Obeisance/Arduino-ECG-Monitor/IMG_20200314_070831966.jpg

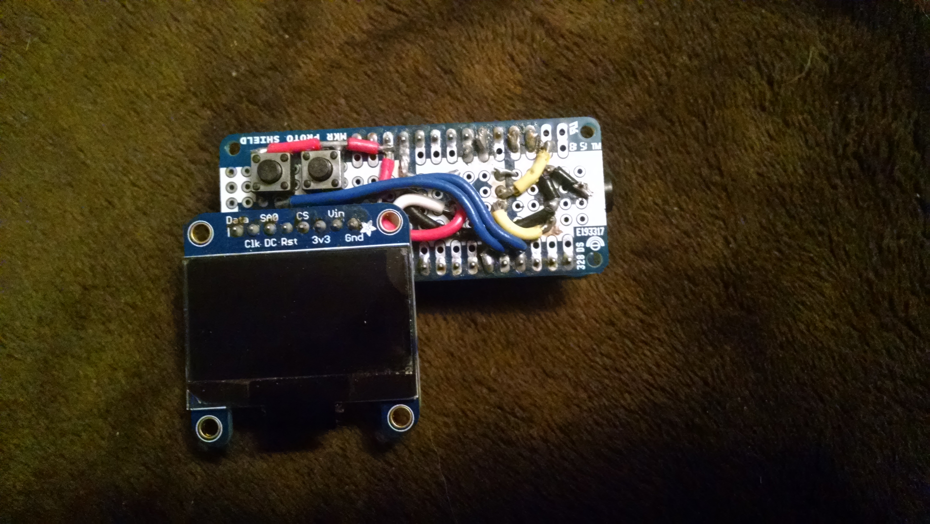
IMG_20200314_070831966.jpg
