Obeisance/Arduino-ECG-Monitor/IMG_20200314_070901912.jpg

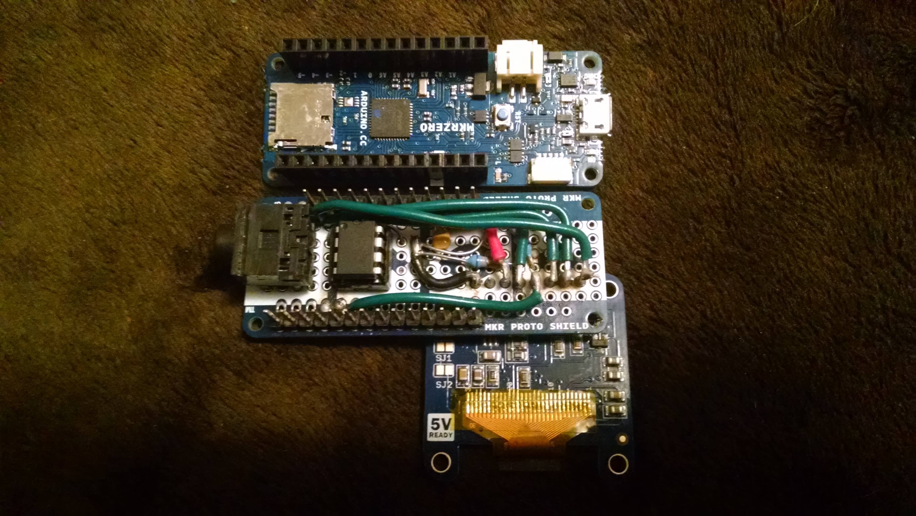
IMG_20200314_070901912.jpg
