Obeisance/Arduino-ECG-Monitor/2022-02-28 ECG normal.png

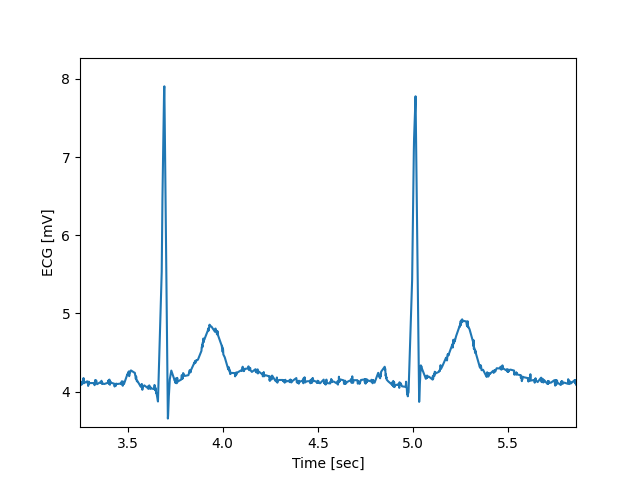
2022-02-28 ECG normal.png
