Obeisance/Arduino-ECG-Monitor/2022-02-28 ECG with pulse change.png

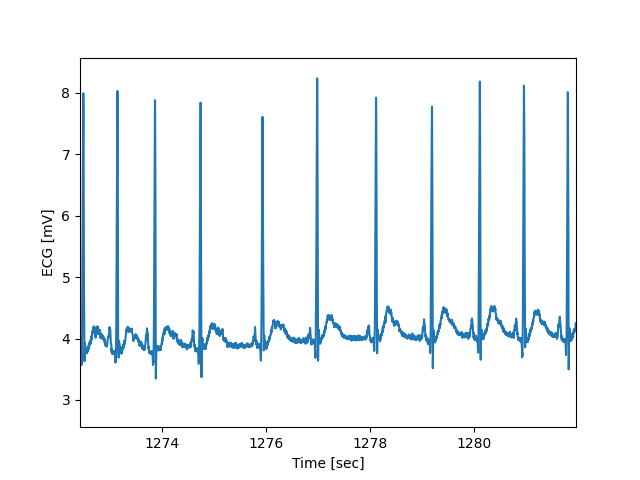
2022-02-28 ECG with pulse change.png
