Obeisance/Arduino-ECG-Monitor/2022-02-28 ECG with PVC during run.png

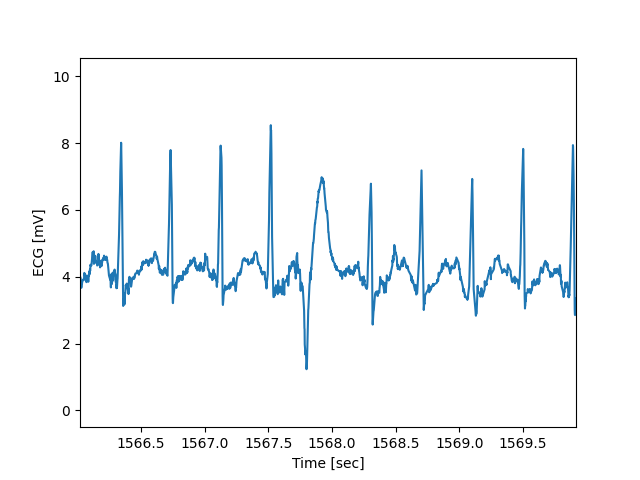
2022-02-28 ECG with PVC during run.png
