Obeisance/Arduino-ECG-Monitor/2022-02-28 pulse incl run.png

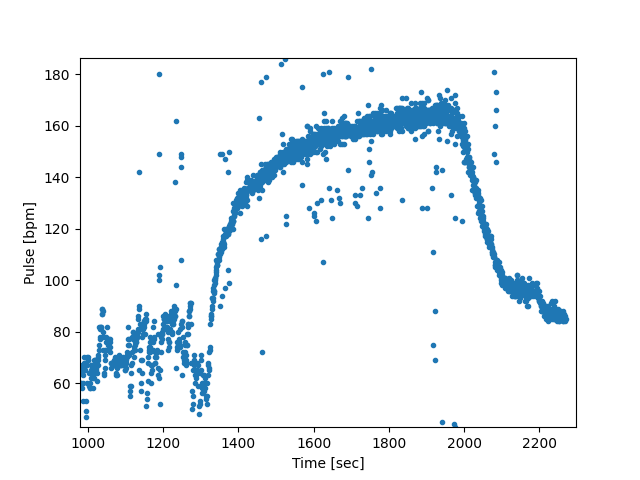
2022-02-28 pulse incl run.png
