Obeisance/Arduino-ECG-Monitor/2020-03-14 ECG part list.xlsx

Component | Part number | Cost (USD) | quantity | link
Arduino MKR zero (I did not include the micro USB cable needed to charge this) | 782-ABX00012 | 24.09 | 1 | https://www.mouser.com/ProductDetail/Arduino/ABX00012
Arduino MKR proto-shield | 782-TSX00001 | 7.99 | 1 | https://www.mouser.com/ProductDetail/?qs=5aG0NVq1C4w1oyNWErt3iA%3D%3D
AD627 Instrumentation amplifier | 584-AD627BNZ | 11.21 | 1 | https://www.mouser.com/ProductDetail/Analog-Devices/AD627BNZ?qs=sGAEpiMZZMsE1dKaA2ImUCv9orK1DwfJVGszVMhWZpw%3D
619 ohm gain resistor | 279-YR1B619RCC | 0.47 | 1 | https://www.mouser.com/ProductDetail/TE-Connectivity-Neohm/YR1B619RCC
8 pin chip socket | 485-2202 | 0.75 | 1 | https://www.mouser.com/ProductDetail/Adafruit/2202
5 pin, 3.5mm audio jack | 1699 | 0.95 | 1 | https://www.adafruit.com/product/1699
OLED, SPI interface, 128x64 px | 938 | 19.95 | 1 | https://www.adafruit.com/product/938
Buttons | 367 | 2.5 | 1 | https://www.adafruit.com/product/367
pull down resistors | 660-MF1/4LCT52R102G | 0.1 | 2 | https://www.mouser.com/ProductDetail/KOA-Speer/MF1-4LCT52R102G
1200 mAh Li Battery (It would be convenient to include a shutoff switch too) | 258 | 9.95 | 1 | https://www.adafruit.com/product/258
Arduino pin headers | 392 | 4.95 | 1 | https://www.adafruit.com/product/392
ECG cable (Olimax, 3.5mm 3-terminal) | CAB-12970 | 15.95 | 1 | https://www.amazon.com/gp/product/B00K9487UC/ref=ppx_yo_dt_b_asin_title_o05_s00?ie=UTF8&psc=1
ECG pads (3M, 2560 red dot pack of 100) | B01AME7YC0 | 12.99 | 1 | https://www.amazon.com/gp/product/B01AME7YC0/ref=ppx_yo_dt_b_asin_title_o08_s00?ie=UTF8&psc=1
micro SD card (any card will do, but for capacity over 32 GB, create <32GB partitions so the Arduino SD library can work) | 467-SDSDQAB-032G-1 | 17.56 | 1 | https://www.mouser.com/ProductDetail/SanDisk/SDSDQAB-032G-1
Various lengths of wire (20-22 gauge), solder
 | Total (USD) | 129.51
