Obeisance/Arduino-ECG-Monitor/Button press.stl

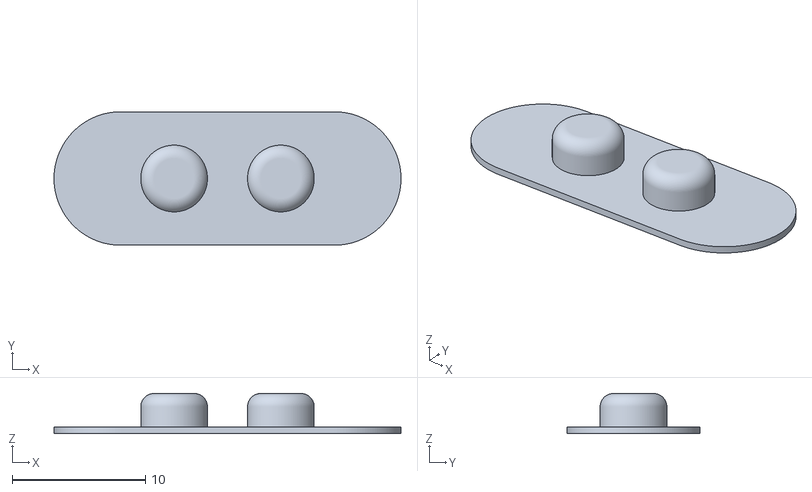
[picture p7: CAD file, 2022-03-12]
Button press.stl
26.0 x 10.0 x 3.00
