Obeisance/Arduino-ECG-Monitor/ECG button v2.stl

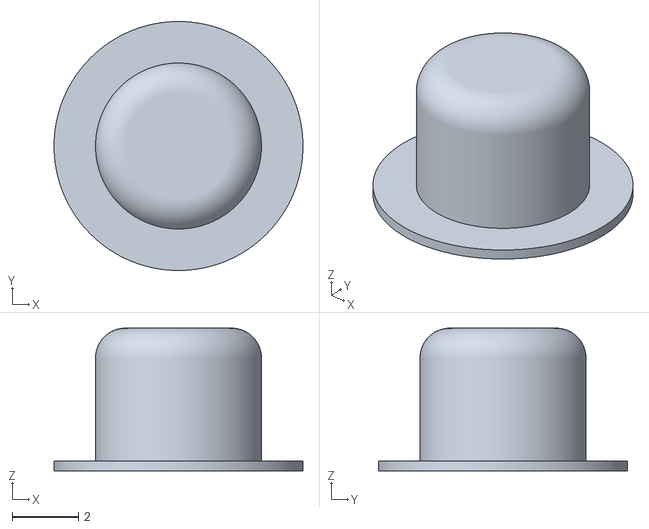
[picture p8: CAD file, 2020-04-19]
ECG button v2.stl
7.50 x 7.50 x 4.30
