Obeisance/Arduino-ECG-Monitor/Heart monitor and battery case.stl

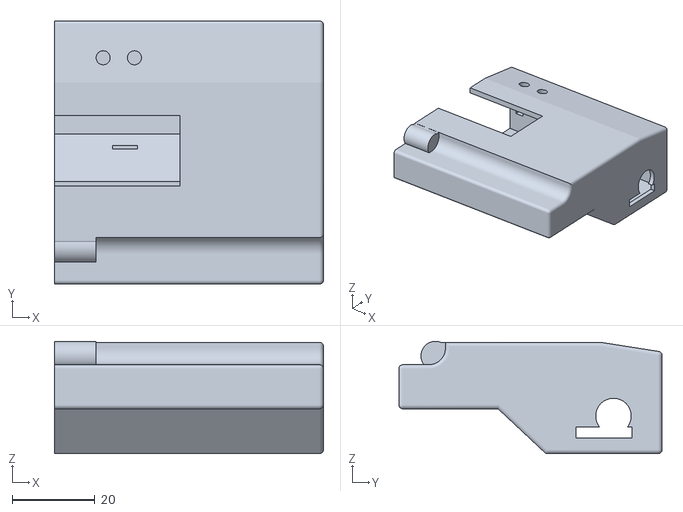
[picture p9: CAD file, 2020-03-14]
Heart monitor and battery case.stl
65.0 x 63.6 x 27.2
