Obeisance/Arduino-ECG-Monitor/Heart monitor and battery case lid.stl

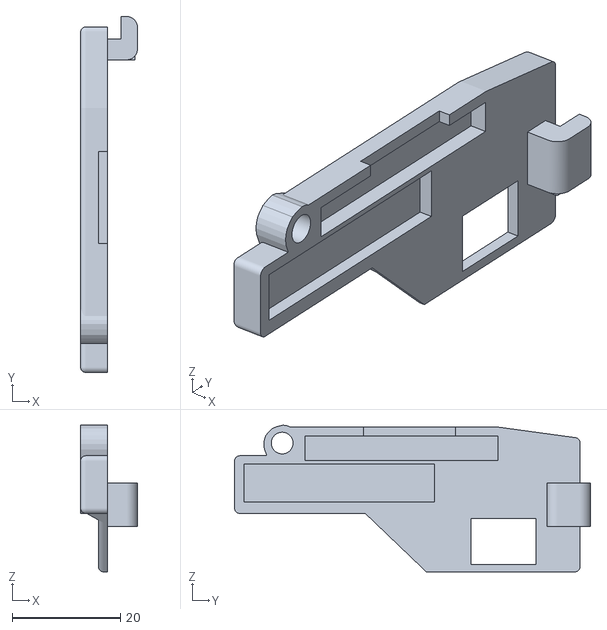
[picture p10: CAD file, 2020-03-14]
Heart monitor and battery case lid.stl
10.5 x 65.7 x 27.1
