Obeisance/Arduino-ECG-Monitor/ECG circuit diagram.pdf

# ECG circuit diagram

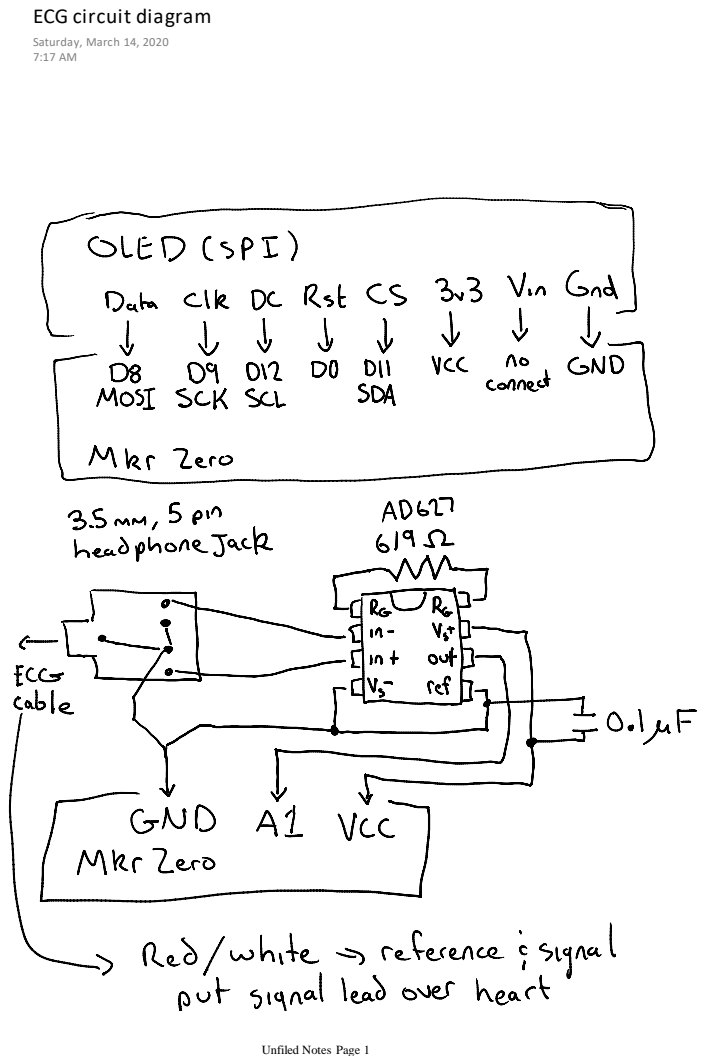
[picture p11: page 1]
Saturday, March 14, 2020 7:17 AM

Unfiled Notes Page 1

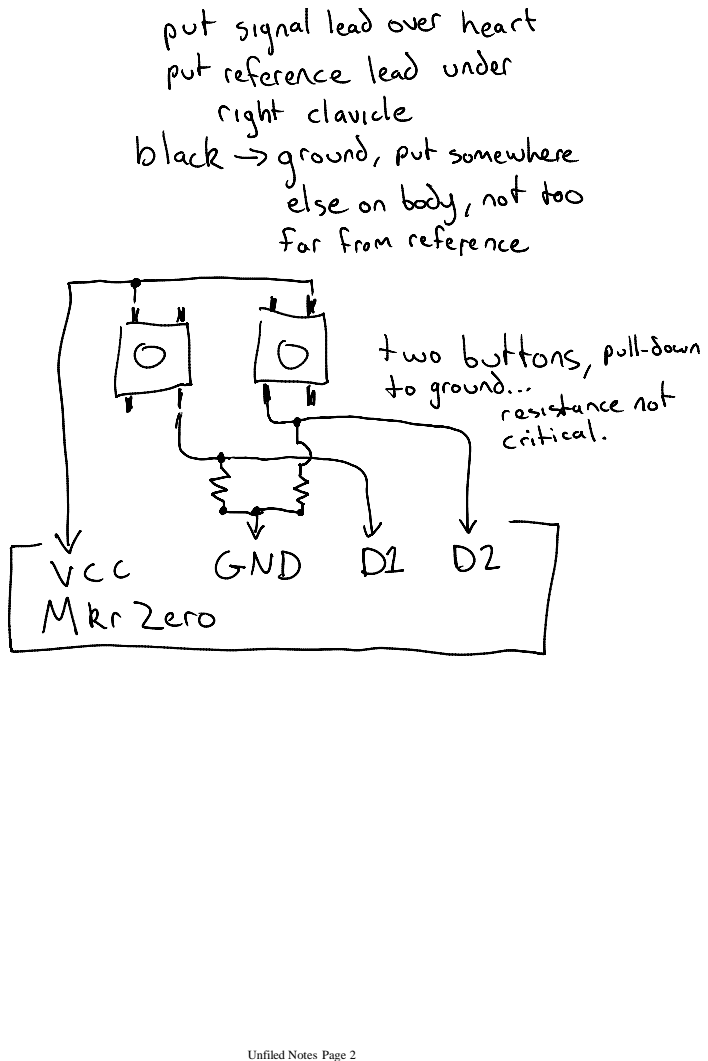
[picture p12: page 2]

Unfiled Notes Page 2
