Obeisance/Arduino-ECG-Monitor/(commit log)

2019-08-04 Initial code upload
    This code runs on an Arduino MKR zero to datalog electrocardiogram data.
    An instrumentation amplifier (Analog devices AD627) is connected to a
    sticky pad over the ventricle and a pad below the right clavicle. A
    third pad is connected to ground. The Arduino will process the data to
    extract pulse, and record the ECG shape to an SD card. At the same time,
    this battery powered device can be carried for a day or so to collect
    high resolution data.
2019-08-07 rescale screen
    added ability to not rescale screen. This helps with identifying when
    the ECG trace is at an edge of the AtoD range (if so, switch lead
    polarity).
2019-08-08 Event monitor
    added capability to record ~30 sec of data to dump to the SD card upon
    demand. This gives a buffer to collect an ECG trace after feeling an
    arrhythmia.
2020-03-14 supplementary information and refined code
    include enough information for others to reproduce this code.
    [2020-03-14 ECG part list.xlsx, Heart monitor and battery case lid.stl, Heart monitor and battery case.stl]
2020-04-19 a bit more cad
    [ECG button v2.stl]
2022-03-12 example data included
    python data processing script and example datalog, with plots. I also included a new stl for the button used in the case - I kept accidentally pressing the button in my pocket.
    [Button press.stl]
